Jaycar-Electronics/uno-programmer/Duinotech_Uno_Programmer/sketch.h

const char PROGMEM sketch[4160]={   //Snake Game Sketch for Uno
0x0C,0x94,0x62,0x00,0x0C,0x94,0x7F,0x00,0x0C,0x94,0x7F,0x00,0x0C,0x94,0x7F,0x00,
0x0C,0x94,0x7F,0x00,0x0C,0x94,0x7F,0x00,0x0C,0x94,0x7F,0x00,0x0C,0x94,0xDE,0x06,
0x0C,0x94,0x7F,0x00,0x0C,0x94,0x7F,0x00,0x0C,0x94,0x7F,0x00,0x0C,0x94,0x7F,0x00,
0x0C,0x94,0x7F,0x00,0x0C,0x94,0x7F,0x00,0x0C,0x94,0x7F,0x00,0x0C,0x94,0x7F,0x00,
0x0C,0x94,0xEC,0x02,0x0C,0x94,0x7F,0x00,0x0C,0x94,0x7F,0x00,0x0C,0x94,0x7F,0x00,
0x0C,0x94,0x7F,0x00,0x0C,0x94,0x7F,0x00,0x0C,0x94,0x7F,0x00,0x0C,0x94,0x7F,0x00,
0x0C,0x94,0x7F,0x00,0x0C,0x94,0x7F,0x00,0x00,0x00,0x00,0x08,0x00,0x02,0x01,0x00,
0x00,0x03,0x04,0x07,0x00,0x00,0x00,0x00,0x00,0x00,0x00,0x00,0x01,0x02,0x04,0x08,
0x10,0x20,0x40,0x80,0x01,0x02,0x04,0x08,0x10,0x20,0x01,0x02,0x04,0x08,0x10,0x20,
0x04,0x04,0x04,0x04,0x04,0x04,0x04,0x04,0x02,0x02,0x02,0x02,0x02,0x02,0x03,0x03,
0x03,0x03,0x03,0x03,0x00,0x00,0x00,0x00,0x23,0x00,0x26,0x00,0x29,0x00,0x00,0x00,
0x00,0x00,0x25,0x00,0x28,0x00,0x2B,0x00,0x00,0x00,0x00,0x00,0x24,0x00,0x27,0x00,
0x2A,0x00,0x02,0x00,0x11,0x24,0x1F,0xBE,0xCF,0xEF,0xD8,0xE0,0xDE,0xBF,0xCD,0xBF,
0x11,0xE0,0xA0,0xE0,0xB1,0xE0,0xE0,0xEA,0xFF,0xE0,0x02,0xC0,0x05,0x90,0x0D,0x92,
0xA0,0x3A,0xB1,0x07,0xD9,0xF7,0x22,0xE0,0xA0,0xEA,0xB1,0xE0,0x01,0xC0,0x1D,0x92,
0xAF,0x34,0xB2,0x07,0xE1,0xF7,0x0E,0x94,0x3B,0x07,0x0C,0x94,0xCE,0x07,0x0C,0x94,
0x00,0x00,0x82,0xE0,0x80,0x93,0xA4,0x01,0x24,0xEF,0x31,0xE0,0x40,0xE0,0x50,0xE0,
0x64,0xE6,0x70,0xE0,0x83,0xE0,0x0C,0x94,0x9A,0x04,0xCF,0x92,0xDF,0x92,0xEF,0x92,
0xFF,0x92,0x0F,0x93,0x1F,0x93,0xCF,0x93,0xDF,0x93,0xC8,0x2E,0xE6,0x2E,0x60,0xE0,
0x85,0xE0,0x0E,0x94,0x3B,0x04,0xC8,0xE0,0xD0,0xE0,0x00,0xE8,0x10,0xE0,0xD1,0x2C,
0xC8,0x01,0x8C,0x21,0x9D,0x21,0x89,0x2B,0x11,0xF0,0x61,0xE0,0x01,0xC0,0x60,0xE0,
0x84,0xE0,0x0E,0x94,0x3B,0x04,0x61,0xE0,0x86,0xE0,0x0E,0x94,0x3B,0x04,0x60,0xE0,
0x86,0xE0,0x0E,0x94,0x3B,0x04,0x15,0x95,0x07,0x95,0x21,0x97,0x49,0xF7,0xC8,0xE0,
0xD0,0xE0,0x00,0xE8,0x10,0xE0,0xF1,0x2C,0xC8,0x01,0x8E,0x21,0x9F,0x21,0x89,0x2B,
0x11,0xF0,0x61,0xE0,0x01,0xC0,0x60,0xE0,0x84,0xE0,0x0E,0x94,0x3B,0x04,0x61,0xE0,
0x86,0xE0,0x0E,0x94,0x3B,0x04,0x60,0xE0,0x86,0xE0,0x0E,0x94,0x3B,0x04,0x15,0x95,
0x07,0x95,0x21,0x97,0x49,0xF7,0x61,0xE0,0x85,0xE0,0xDF,0x91,0xCF,0x91,0x1F,0x91,
0x0F,0x91,0xFF,0x90,0xEF,0x90,0xDF,0x90,0xCF,0x90,0x0C,0x94,0x3B,0x04,0x1F,0x93,
0xCF,0x93,0xDF,0x93,0xEC,0x01,0x11,0xE0,0x69,0x91,0x81,0x2F,0x0E,0x94,0x8D,0x00,
0x1F,0x5F,0x19,0x30,0xC9,0xF7,0xDF,0x91,0xCF,0x91,0x1F,0x91,0x08,0x95,0xCF,0x93,
0xDF,0x93,0x80,0xE5,0x90,0xE0,0xA0,0xE0,0xB0,0xE0,0x80,0x93,0x00,0x01,0x90,0x93,
0x01,0x01,0xA0,0x93,0x02,0x01,0xB0,0x93,0x03,0x01,0xC0,0x91,0xA5,0x01,0xD0,0x91,
0xA6,0x01,0xCE,0x01,0x64,0xE6,0x70,0xE0,0x0E,0x94,0x4B,0x07,0xCB,0x01,0x2A,0xE0,
0x30,0xE0,0xB9,0x01,0x0E,0x94,0x4B,0x07,0xFC,0x01,0xEE,0x0F,0xFF,0x1F,0xE8,0x0F,
0xF9,0x1F,0xE1,0x58,0xFE,0x4F,0x80,0x81,0x80,0x93,0x22,0x01,0x81,0x81,0x80,0x93,
0x23,0x01,0x82,0x81,0x80,0x93,0x24,0x01,0xCE,0x01,0xB9,0x01,0x0E,0x94,0x4B,0x07,
0xEC,0x01,0xCB,0x01,0xB9,0x01,0x0E,0x94,0x4B,0x07,0xFC,0x01,0xEE,0x0F,0xFF,0x1F,
0xE8,0x0F,0xF9,0x1F,0xE1,0x58,0xFE,0x4F,0x80,0x81,0x80,0x93,0x26,0x01,0x81,0x81,
0x80,0x93,0x27,0x01,0x82,0x81,0x80,0x93,0x28,0x01,0xFE,0x01,0xEE,0x0F,0xFF,0x1F,
0xEC,0x0F,0xFD,0x1F,0xE1,0x58,0xFE,0x4F,0x80,0x81,0x80,0x93,0x2A,0x01,0x81,0x81,
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
